Alexandr-Filatov/PDU_Container_MCU_PCB/Docs/Report Docs/Плата управления БРВН BOM_v1.0.xlsx

Позиционное обозначение | Номинал | Наименование | Замена | Корпус | Описание | Кол-во | DNP
C23, C25, C52, C54, C62, C64 | 0.1u |  |  | SMD 0805 | Capacitor SMD 50V | 6
C48 | 0.1u |  |  | SMD 1206 | Capacitor SMD 50V | 1
C10, C43, C58 | 0.27u |  |  | SMD 0805 | Capacitor SMD 50V | 3
C2, C3, C4, C5, C7, C11, C13, C14, C15, C17, C18, C41, C56, C59, C65, C73, C78 | 100n |  |  | SMD 0805 | Capacitor SMD 50V | 17
C20, C49, C67 | 10n |  |  | SMD 0805 | Capacitor SMD 50V | 3
C70, C71, C72, C80 | 10u |  |  | SMD 0805 | Capacitor SMD 50V | 4
C34, C35, C36, C37, C38, C44, C47, C66, C81, C82, C83, C85, C86, C87, C89, C90, C91, C92 | 10u |  |  | SMD 1206 | Capacitor SMD 50V | 18
C26, C30 | 12p |  |  | SMD 0805 | Capacitor SMD 50V | 2
C19, C74, C75, C76, C77 | 1u |  |  | SMD 0805 | Capacitor SMD 50V | 5
C39 | 1u |  |  | SMD 1206 | Capacitor SMD 50V | 1
C21, C22, C24, C27, C46, C53, C61, C63 | 2.2u |  |  | SMD 0805 | Capacitor SMD 50V | 8
C79, C84, C88 | 330u | EEUFR1H331L |  | CP Radial D10.0mm P5.00mm | Polarized capacitor | 3
C16 | 4.7u |  |  | SMD 0805 | Capacitor SMD 50V | 1
C68, C69 | 4.7u |  |  | SMD 1206 | Capacitor SMD 50V | 2
C1, C9, C12, C40, C42, C45, C55, C57, C60 | 56p |  |  | SMD 0805 | Capacitor SMD 50V | 9
D7, D16, D83 | ~ | S1M |  | SMA | Diode | 3
D24, D28, D32, D36 | ~ | RS1B |  | SMA | Fast recovery diode | 4
D20 | ~ | SMCJ33A |  | SMC | Supressor | 1
D8, D42 | ~ | FYLS-0603UBC |  | SMD 0805 | Blue LED | 2
D25, D29, D33, D37 | ~ | FYLS-0805UBC |  | SMD 0805 | Blue LED | 4
D11, D17, D22, D27, D31, D35, D39, D41 | ~ | FYLS-0805UYC |  | SMD 0805 | Yellow LED | 8
D6, D10, D81 | ~ | TO-3216BC-MYF |  | SMD 1206 | Yellow LED | 3
D40 | ~ | BZT52C10 |  | SOD-123 | Zener_Diode | 1
D5 | ~ | LBAT54HT1G |  | SOD-323 | Diode | 1
D2, D15, D82 | ~ | NSI1311 |  | SOIC-8 7.5x5.85mm P1.27mm | Isolated amplifier | 3
D14 | ~ | SM24CANB-02HTG |  | SOT-23 | Dual Line CAN Bus Protector, 24Vrwm | 1
D1, D3, D4, D9, D26, D30, D34, D38, D80 | ~ | BAT54S |  | SOT-23 | Schottky barrier diode | 9
D12 | ~ | TD301MCANFD |  | TD5(3)01MCANFD |  | 1
D21, D23 | ~ | UWE1215S-3WR3 |  | UWE S-3WR3 | DC/DC | 2
D18, D19 | ~ | WRB2405S-3WR2 |  | WRB S-3WR2 | DC/DC | 2
J3, J4, J5, J7, J8, J9, J10, J11, J12, J13, J14, J15, J32, J33 | ~ | DS1073-01-2x1-MVT6 |  | Mini-Fit 01x02 | Connector | 14
J6, J16, J17, J34, J35 | ~ | DS1073-01-2x2-MVT6 |  | Molex Mini-Fit Jr 5566-04A 2x02 P4.20mm | Connector | 5
J1 | ~ | KLS1-207-1-04-S | DS-1021-1x4 | PinHeader 1x04 P2.54mm | Connector | 1
L4, L6 | 4.7u | LQH44PN4R7MP0L |  | SMD 1210 | Inductor SMD | 2
L2 | 4.7u | NLC453232T-4R7K-PF |  | SMD 1812 | Inductor SMD | 1
L5, L7 | 470u | B82790C0474N215 |  | B82790S0513N201 | Inductor common mode SMD | 2
L3 | 6.8u | LQH32CN6R8M53L |  | SMD 1210 | Inductor SMD | 1
L1 | ~ | ACM2520-301-2P-T002 |  | CommonModeChoke TDK ACM2520-2P | Inductor SMD | 1
Q2, Q3, Q4, Q5 | ~ | BSP75N |  | SOT-223 | Self-Protected Low Side Driver with Temperature and Current Limit, SOT−223 | 4
Q7, Q8 | ~ | BC847 |  | SOT-23 | Bipolar N | 2
Q9, Q10 | ~ | BC857 |  | SOT-23 | Bipolar P | 2
Q1, Q6 | ~ | 20N06 |  | TO-252-2 | N_channel MOSFET | 2
R57 | 1.1k |  |  | SMD 0805 | Resistor SMD | 1
R55 | 100k |  |  | SMD 0805 | Resistor SMD | 1
R11, R14, R24, R62, R65, R68, R71, R74, R77, R80, R83, R88, R89, R90, R91 | 10k |  |  | SMD 0805 | Resistor SMD | 15
R7, R42, R135 | 120 |  |  | SMD 0805 | Resistor SMD | 3
R56, R87 | 14.3 |  |  | SMD 2512 | Resistor SMD | 2
R25, R26, R27, R28, R31, R34, R48, R51, R132 | 150k |  |  | SMD 2512 | Resistor SMD | 9
R4, R8, R12, R13, R18, R21, R33, R43, R46, R47, R59, R86, R92, R136, R139, R140 | 1k |  |  | SMD 0805 | Resistor SMD | 16
R54, R95 | 20 |  |  | SMD 0805 | Resistor SMD | 2
R23 | 23.2k |  |  | SMD 0805 | Resistor SMD | 1
R1, R2, R3, R6, R29, R30, R32, R41, R49, R50, R53, R134 | 2M |  |  | SMD 1206 | Resistor SMD | 12
R63, R69, R75, R81 | 3.3k |  |  | SMD 0805 | Resistor SMD | 4
R60, R66, R72, R78 | 330 |  |  | SMD 0805 | Resistor SMD | 4
R85 | 4.7k |  |  | SMD 0805 | Resistor SMD | 1
R84 | 470k |  |  | SMD 0805 | Resistor SMD | 1
R10, R45, R138 | 49.9 |  |  | SMD 0805 | Resistor SMD | 3
R37, R40 | 59 |  |  | SMD 0805 | Resistor SMD | 2
R39, R52 | 750 |  |  | SMD 0805 | Resistor SMD | 2
R61, R64, R67, R70, R73, R76, R79, R82 | 8.2k |  |  | SMD 0805 | Resistor SMD | 8
R5, R9, R38, R44, R133, R137 | 8k |  |  | SMD 1206 | Resistor SMD | 6
U7, U8, U9, U10, U11, U12, U13, U14 | ~ | PC817 |  | DIP-4 W7.62mm | Optocoupler | 8
U5 | ~ | APM32F405RGT6 |  | LQFP-64 10x10mm P0.5mm | MCU | 1
U4, U31 | ~ | TLV1117LV33DCYR |  | SOT-223-3 | Linear regulator | 2
U2, U3, U6, U17, U32, U33 | ~ | OPA333xxDBV |  | SOT-23-5 | Op-Amp | 6
U16 | ~ | USBLC6-2P6 |  | SOT-23-6 | ESD protection | 1
U15 | ~ | HT7550-1 |  | SOT-89-3 | Linear regulator | 1
Y1 | 16M | X322516MOB4SI |  | Crystal SMD SeikoEpson FA238-4Pin 3.2x2.5mm | Crystal | 1
