Alexandr-Filatov/PDU_Container_MCU_PCB/3D/WRA_S-3WR2.stp

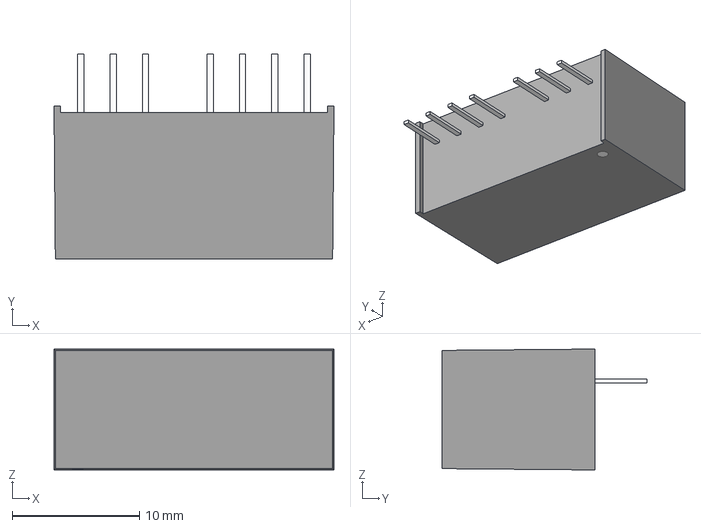
[picture p1: CAD file, 2026-06-05]
3D/WRA_S-3WR2.stp
22.0 x 16.1 x 9.50 mm
PIN_3_1_1_1 x 7
