Alexandr-Filatov/PDU_Container_MCU_PCB/3D/1-776087-1_v2.stp

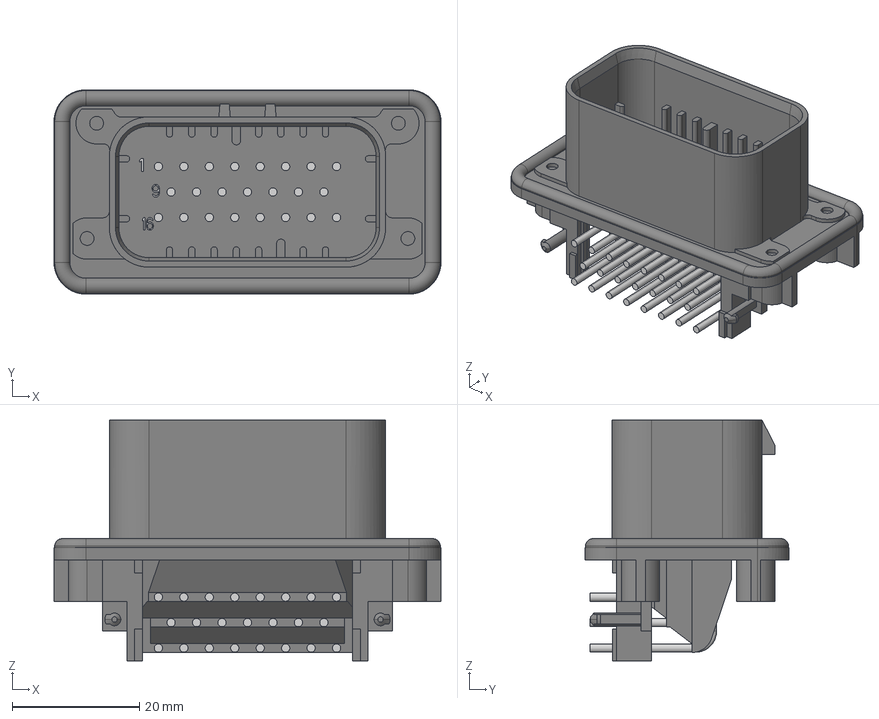
[picture p3: CAD file, 2026-06-05]
3D/1-776087-1_v2.stp
60.8 x 32.1 x 37.8 mm
