Alexandr-Filatov/PDU_Container_MCU_PCB/3D/FL2D-30-103.stp

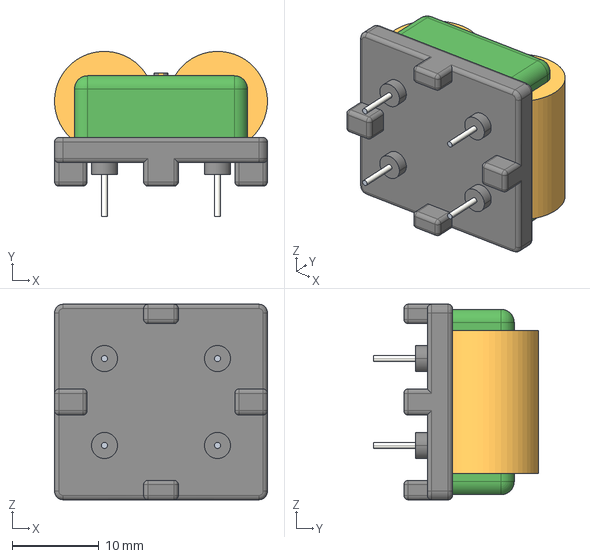
[picture p4: CAD file, 2026-06-05]
3D/FL2D-30-103.stp
24.5 x 19.0 x 22.5 mm
