Alexandr-Filatov/PDU_Container_MCU_PCB/3D/SMD Fuse SF-2410SP.stp

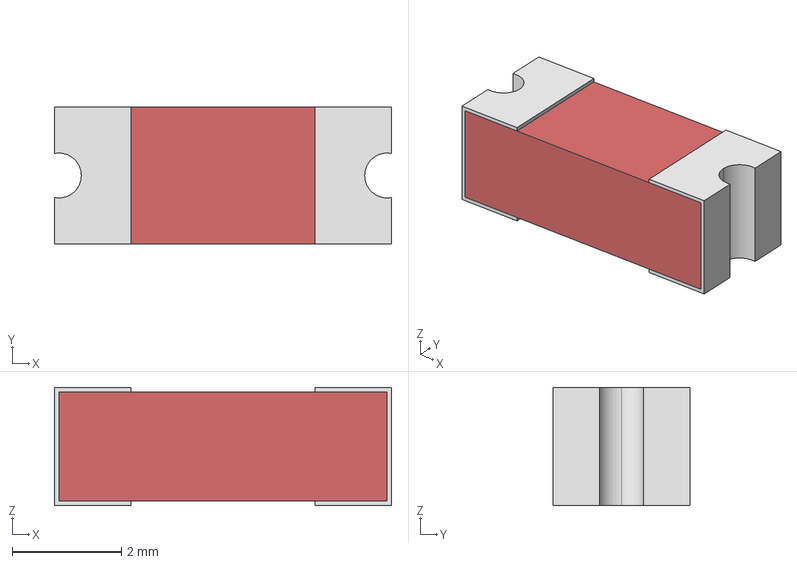
[picture p5: CAD file, 2026-06-05]
3D/SMD Fuse SF-2410SP.stp
6.16 x 2.50 x 2.16 mm
