Alexandr-Filatov/PDU_Container_MCU_PCB/3D/UWE_S-3WR3.stp

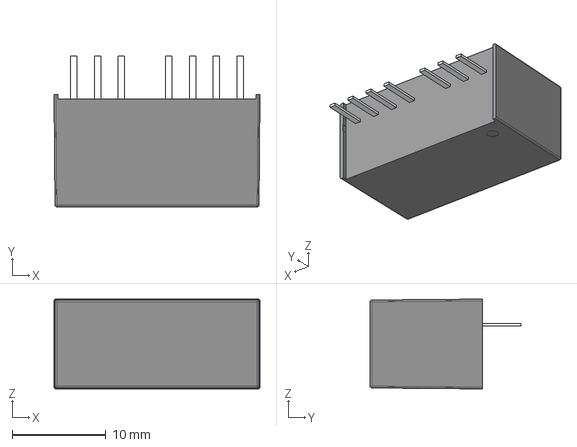
[picture p7: CAD file, 2026-06-05]
3D/UWE_S-3WR3.stp
22.0 x 16.1 x 9.60 mm
