Alexandr-Filatov/PDU_Container_MCU_PCB/3D/NSI1311.stp

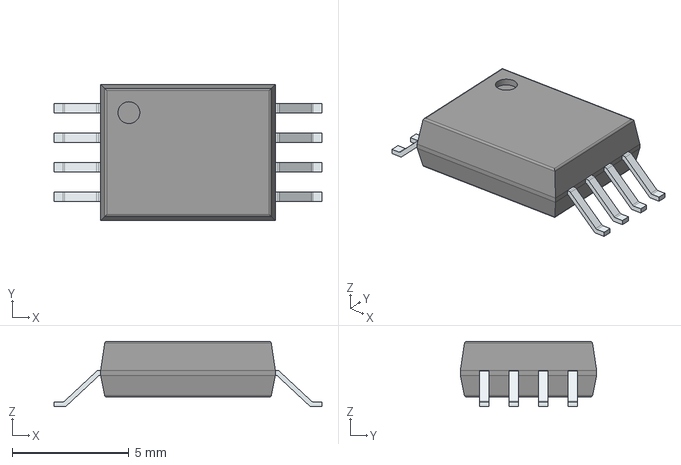
[picture p8: CAD file, 2026-06-05]
3D/NSI1311.stp
11.5 x 5.85 x 2.80 mm
PinsArrayLR
