Alexandr-Filatov/PDU_Container_MCU_PCB/3D/TD5(3)01MCAN.stp

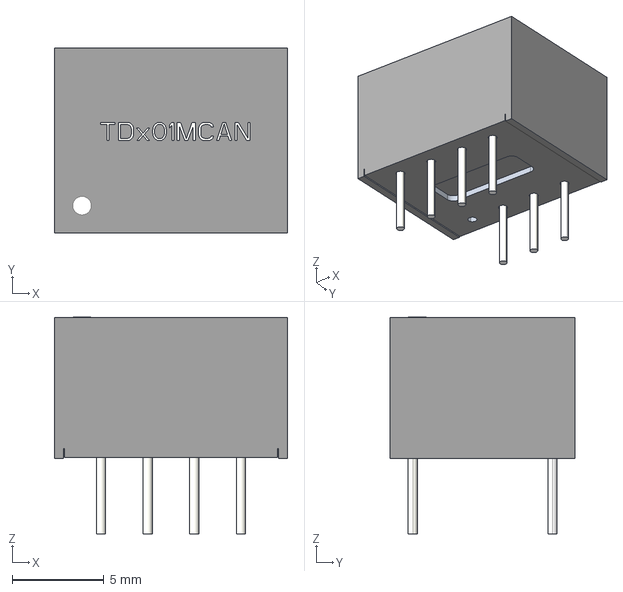
[picture p10: CAD file, 2026-06-05]
3D/TD5(3)01MCAN.stp
12.7 x 10.1 x 11.8 mm
