Alexandr-Filatov/PDU_Container_MCU_PCB/3D/IND_DLW5BS_2020_MUR.step

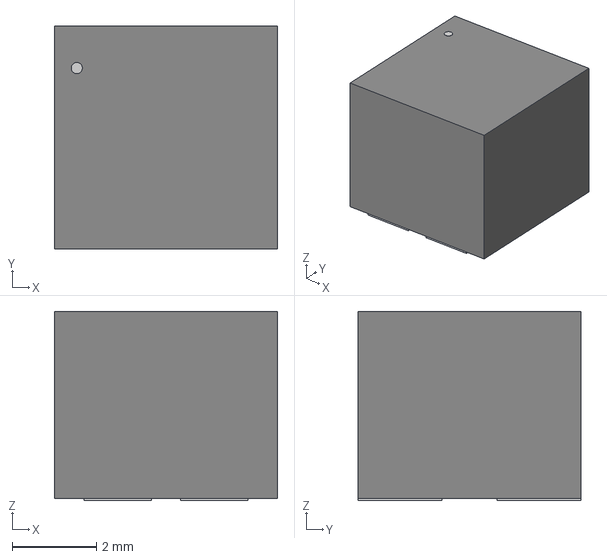
[picture p11: CAD file, 2026-06-05]
3D/IND_DLW5BS_2020_MUR.step
5.30 x 5.30 x 4.50 mm
