Alexandr-Filatov/PDU_Container_MCU_PCB/3D/Tyco KiloVac EV200 Contactor.STEP

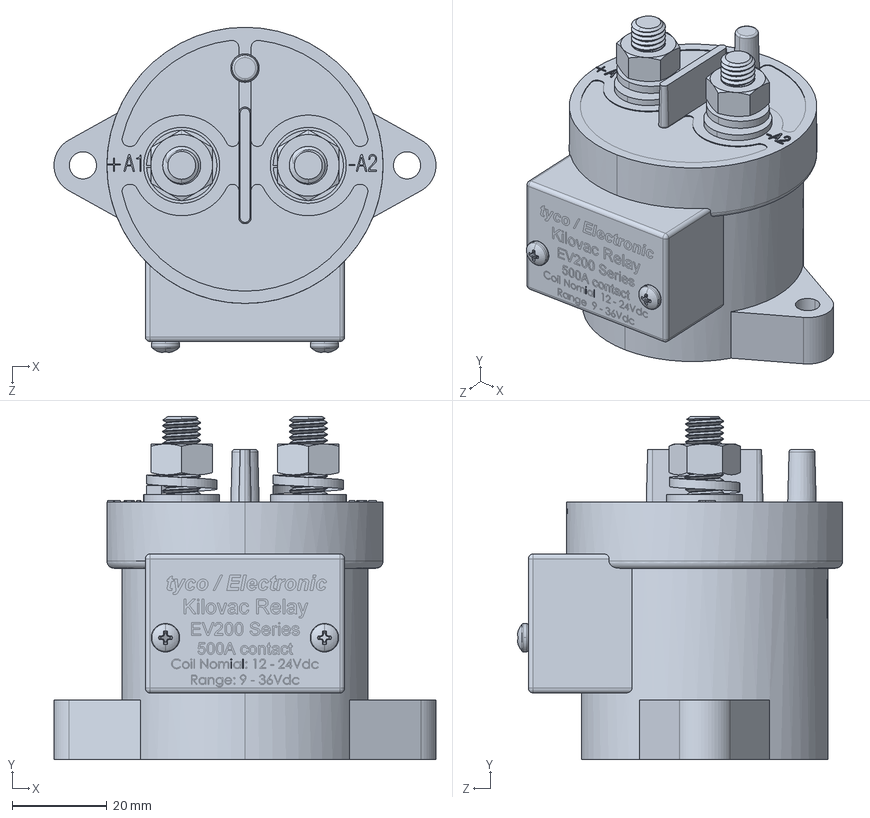
[picture p12: CAD file, 2026-06-05]
3D/Tyco KiloVac EV200 Contactor.STEP
80.5 x 72.3 x 68.6 mm
