Alexandr-Filatov/PDU_Container_MCU_PCB/3D/0039288040.stp

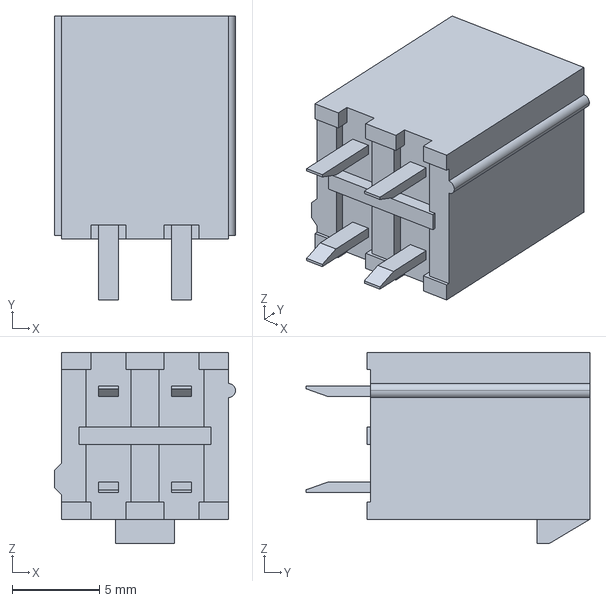
[picture p13: CAD file, 2026-06-05]
3D/0039288040.stp
10.4 x 16.3 x 11.0 mm
