Alexandr-Filatov/PDU_Container_MCU_PCB/3D/2071583-4.stp

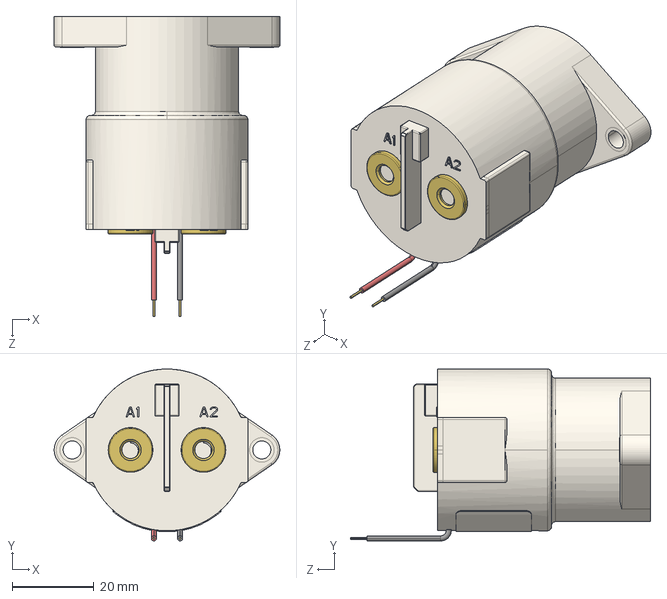
[picture p14: CAD file, 2026-06-05]
3D/2071583-4.stp
55.1 x 42.0 x 73.2 mm
