Alexandr-Filatov/PDU_Container_MCU_PCB/3D/0353180420.stp

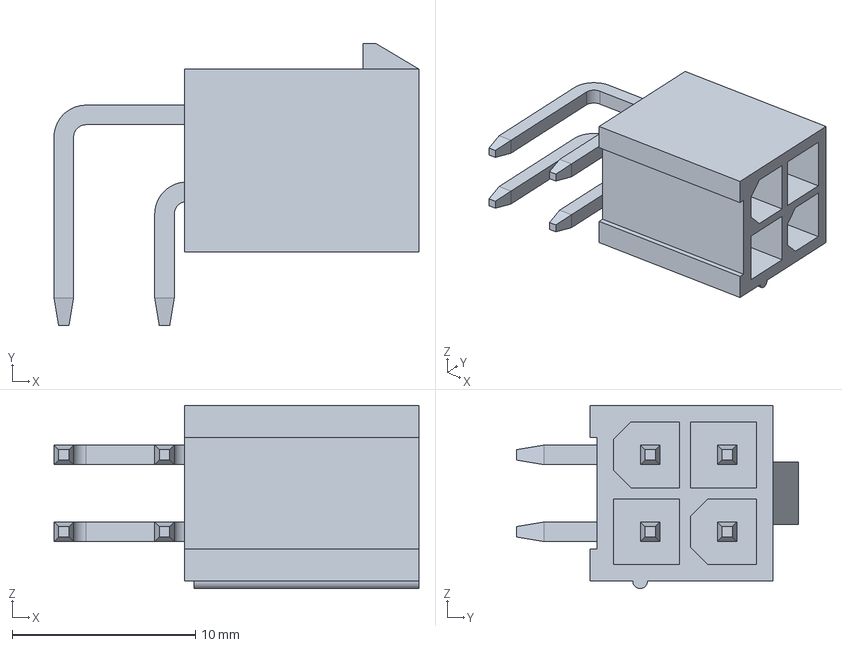
[picture p15: CAD file, 2026-06-05]
3D/0353180420.stp
19.9 x 15.4 x 10.0 mm
