Alexandr-Filatov/PDU_Container_MCU_PCB/3D/0300700235.stp

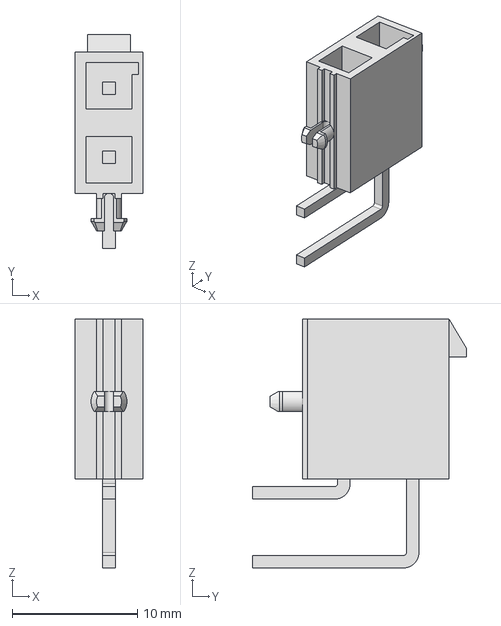
[picture p16: CAD file, 2026-06-05]
3D/0300700235.stp
5.40 x 17.1 x 19.9 mm
