Alexandr-Filatov/PDU_Container_MCU_PCB/(list of files, cad)

Other CAD files:
Drawings/НВЦТ.EVP150-2-1.2000.120_v1.dwg
3D/1-776087-1.step
3D/0039281063.stp
3D/039288020.stp
3D/B82790C0474N215.stp
