Alexandr-Filatov/PDU_Container_MCU_PCB/Docs/Report Docs/Плата управления БРВН монтажная схема вид снизу_v1.0.pdf

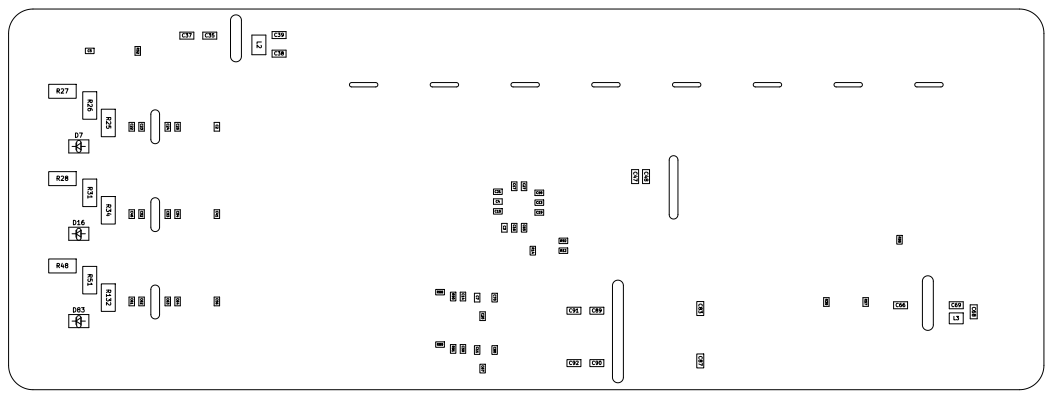
[picture p18: page 1]

Size: A2 | Rev:
KiCad E.D.A. 10.0.1 | Id: 1/1
