Alexandr-Filatov/PDU_Container_MCU_PCB/Docs/Report Docs/Плата управления БРВН схема Э2_v1.0.pdf

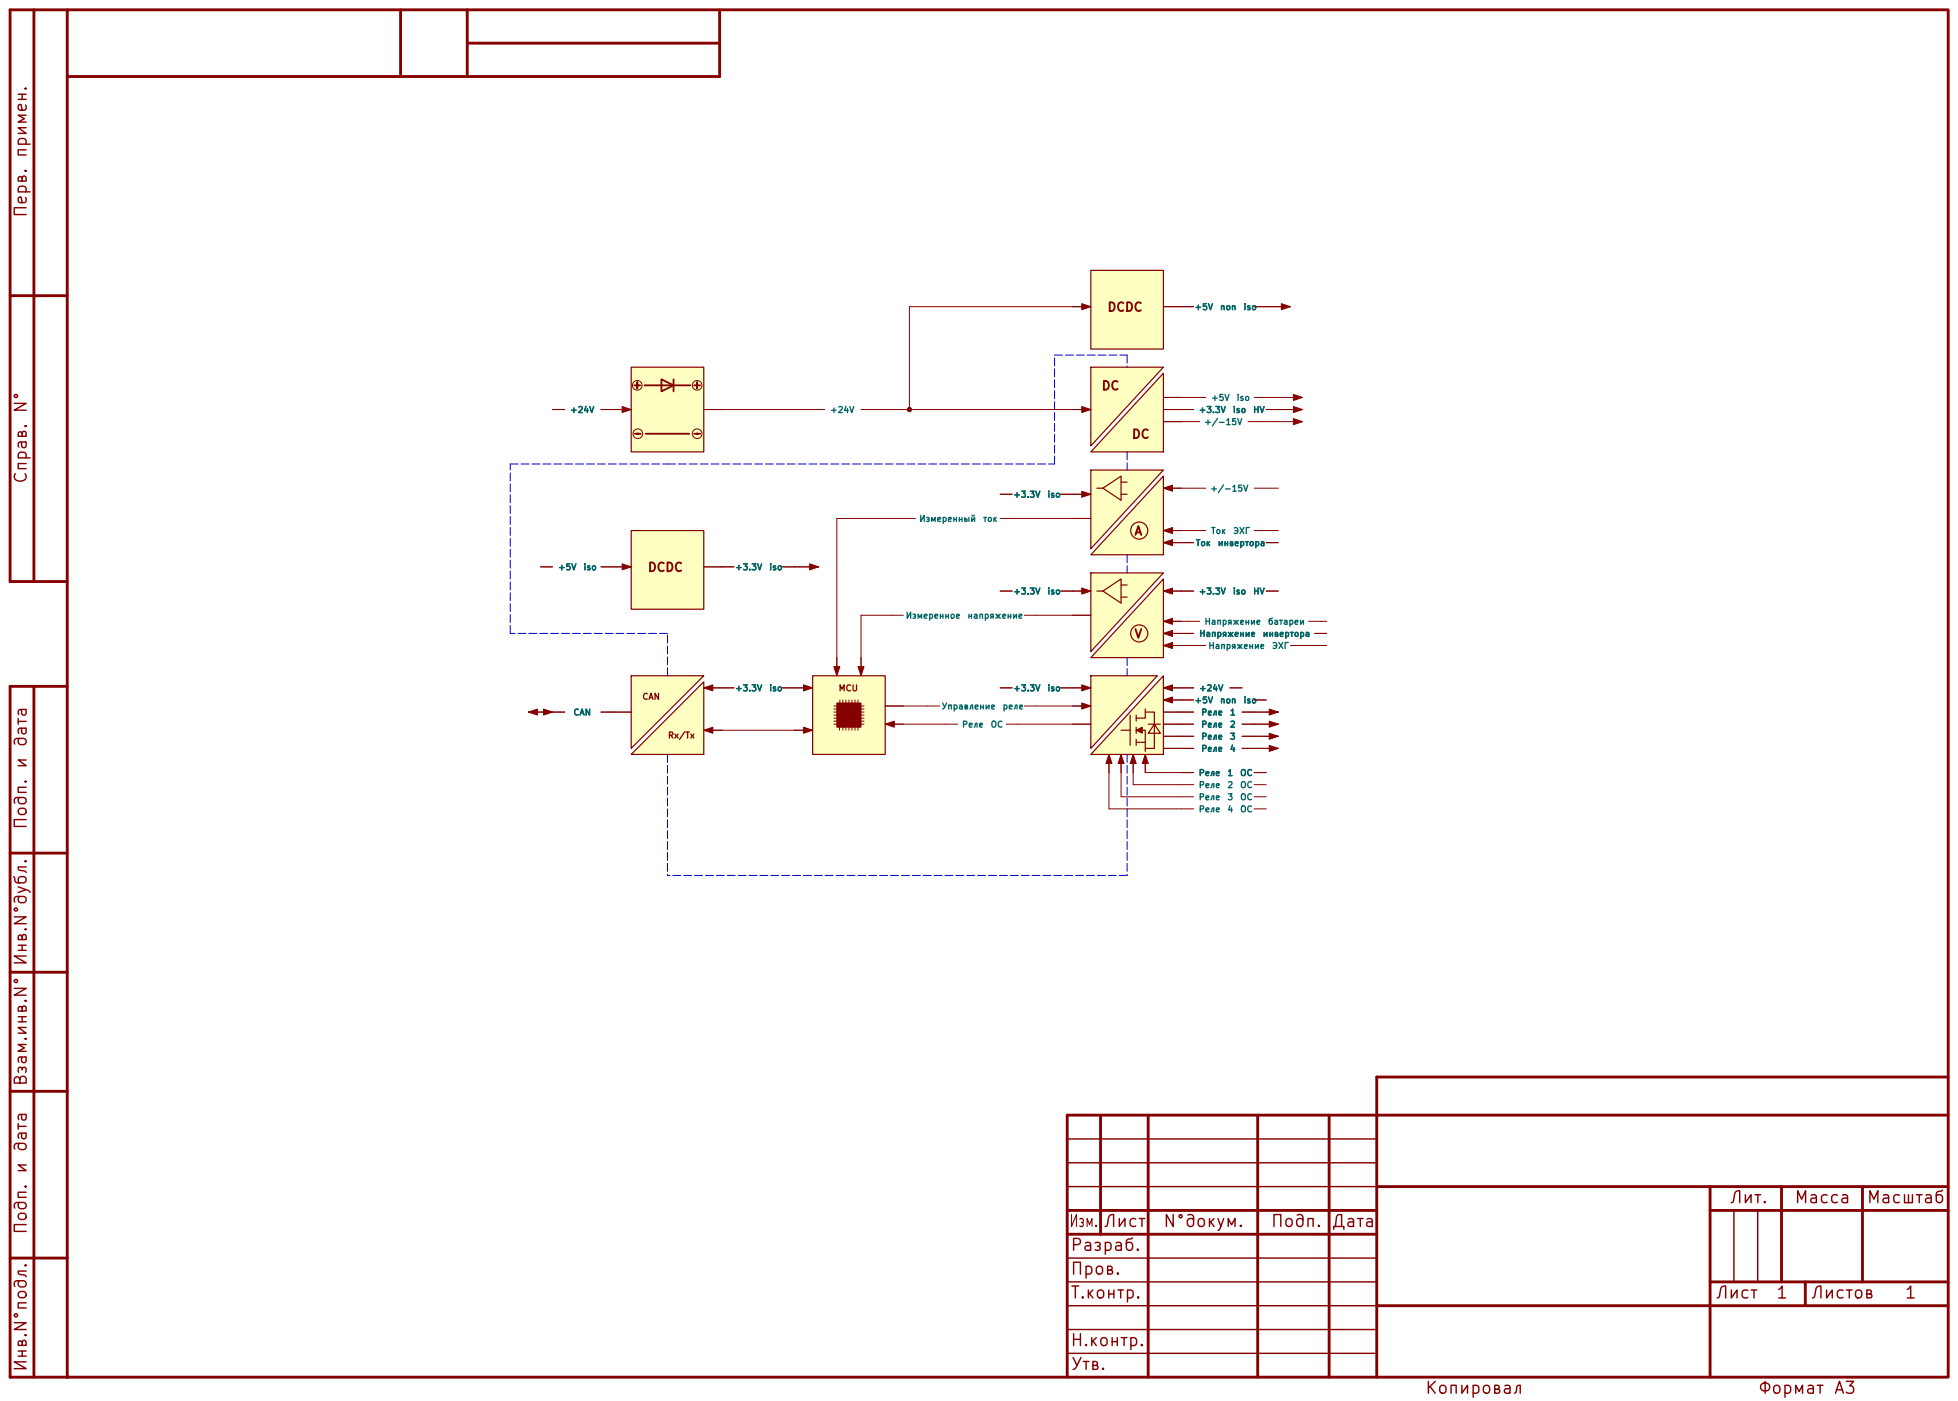
[picture p19: page 1]

Н.контр. Перв. примен. Подп. и дата Подп. и дата

Ток инвертора +3.3V iso HV Реле 4 Реле 1 ОС

Напряжение инвертора Реле 4 Реле 2 ОС
Реле 1 ОС Напряжение ЭХГ +5V non iso Реле 3 Реле 1 +24V

Пров.
Т.контр.
