Alexandr-Filatov/PDU_Container_MCU_PCB/Docs/Report Docs/Плата управления БРВН схема Э3_v1.0.pdf

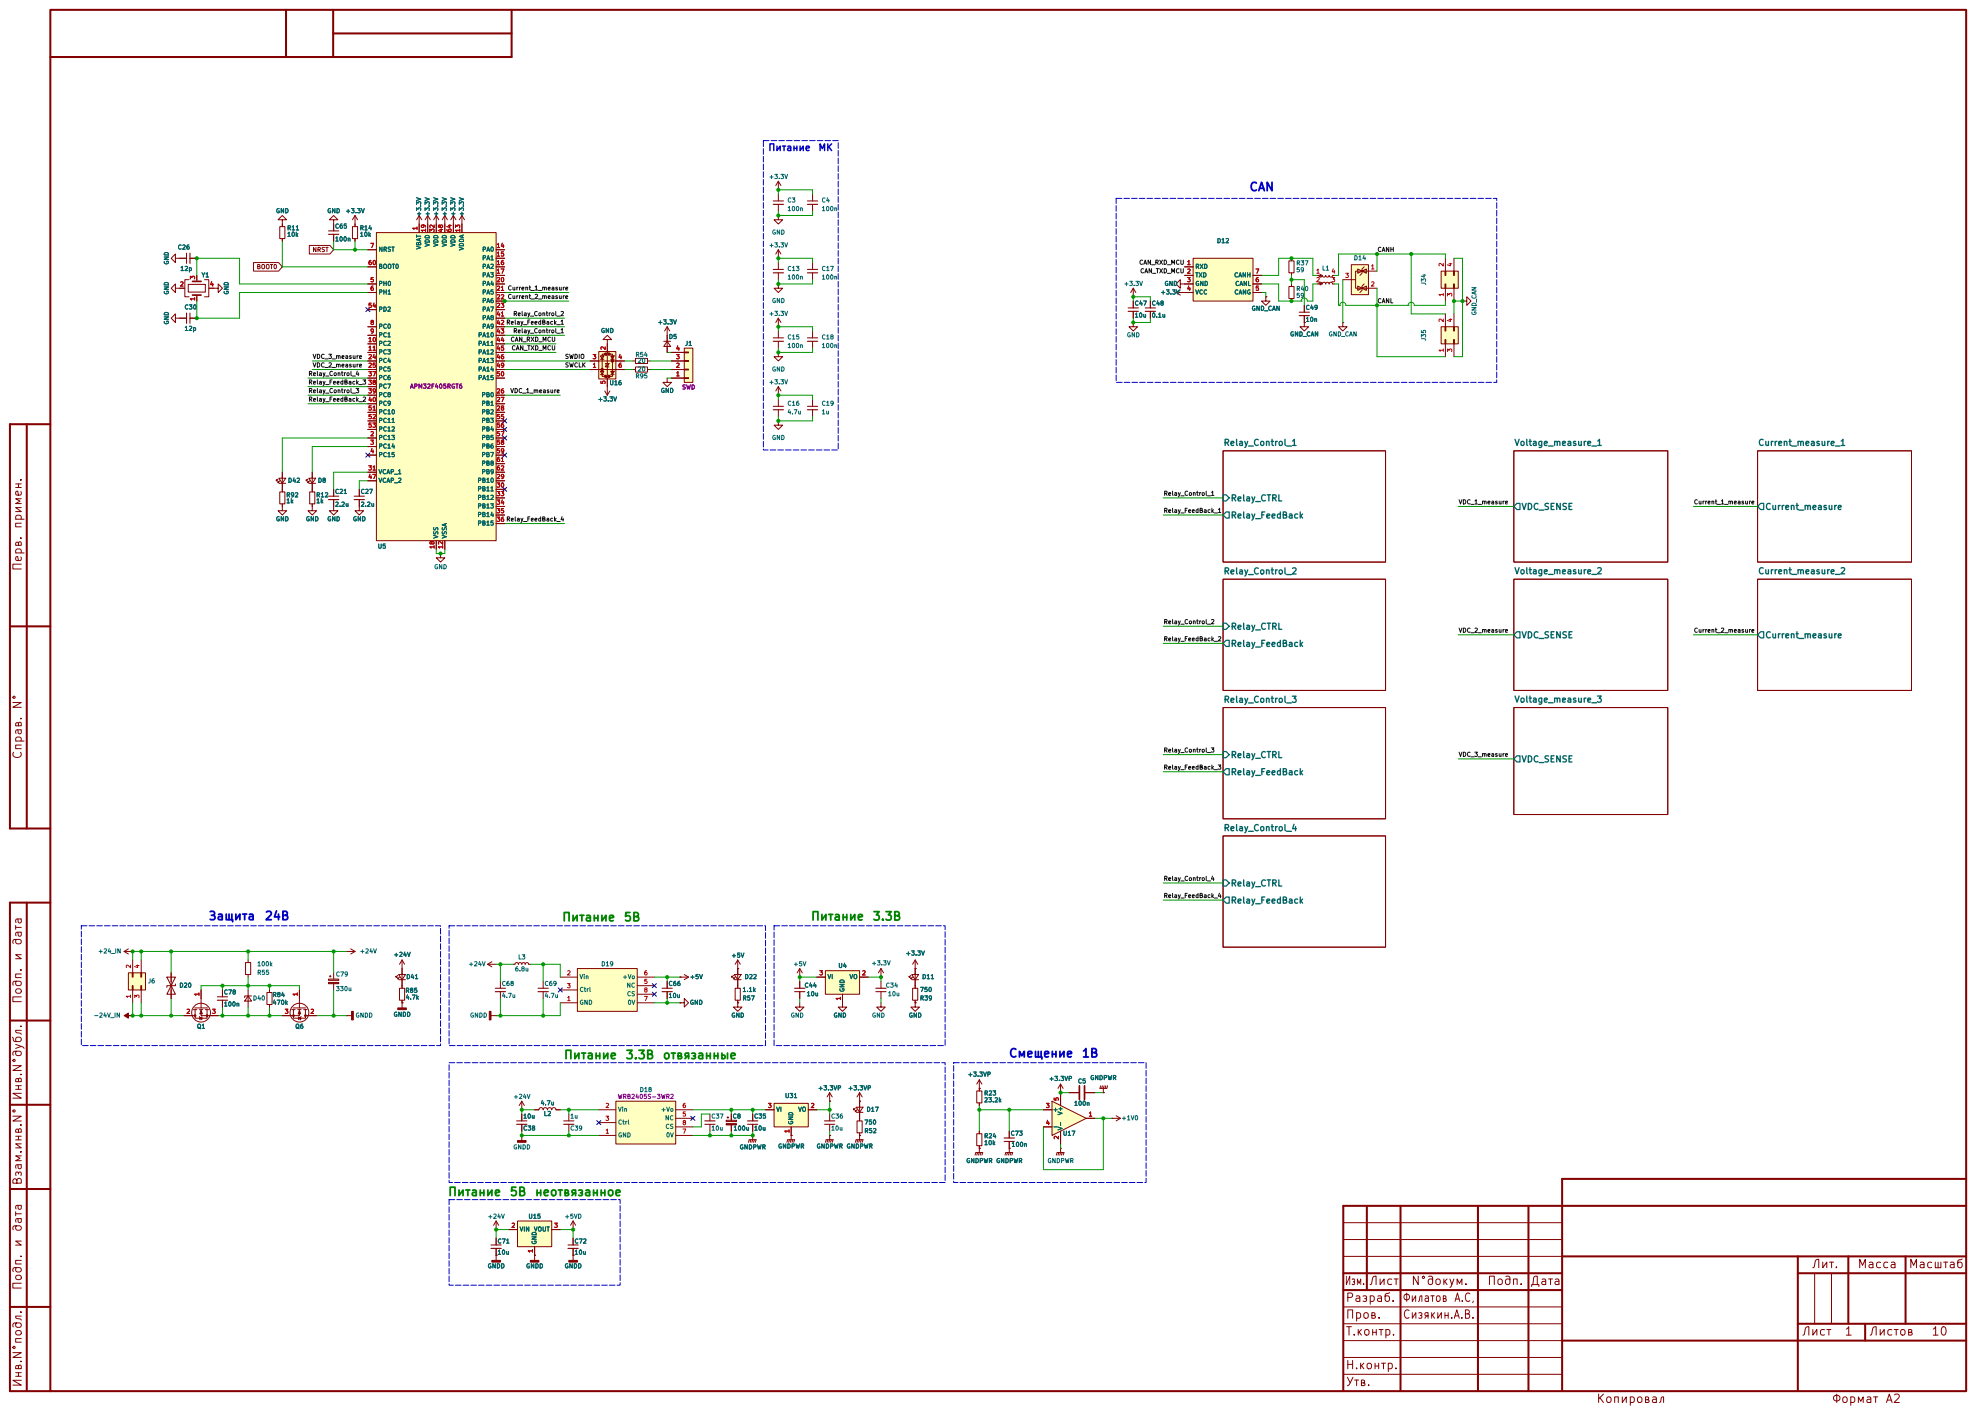
[picture p20: page 1]

Н.контр. Перв. примен. Подп. и дата Подп. и дата

Лист | | Подп.
Филатов А.С,

Пров. | | Сизякин.А.В.
Т.контр.

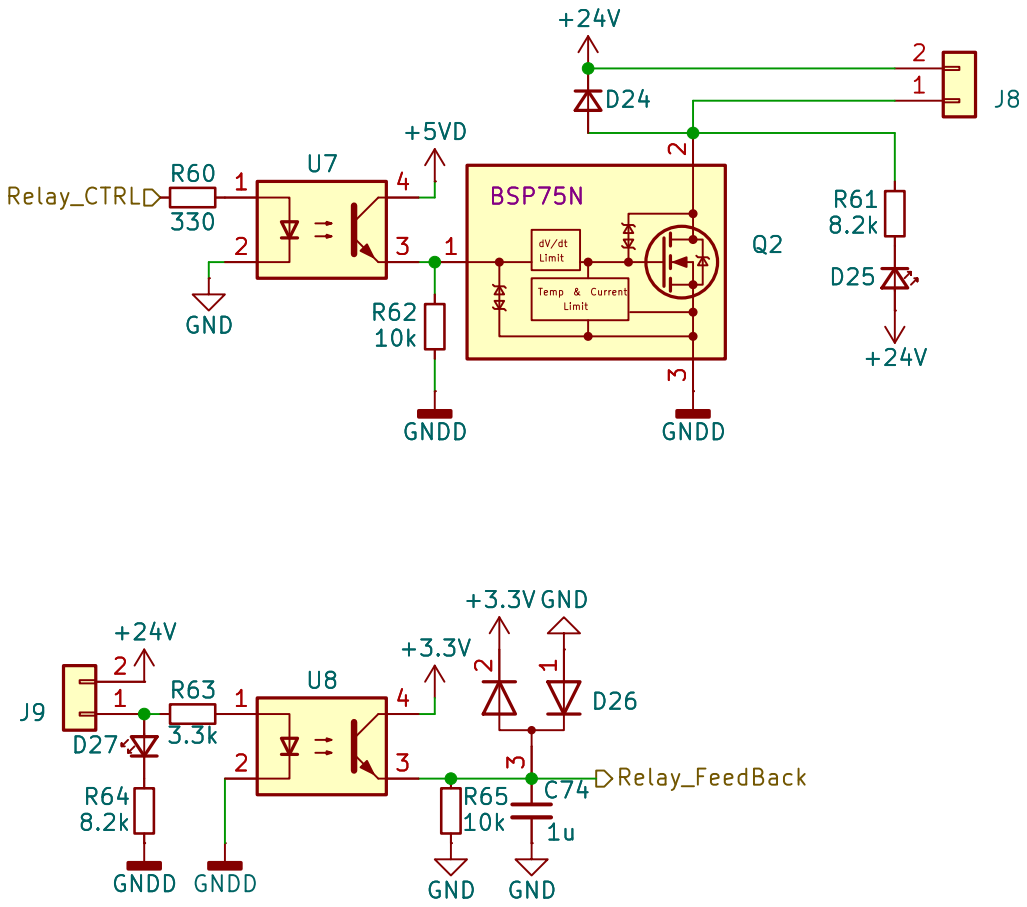
[picture p21: page 2]

Лист Подп. и дата Подп. и дата

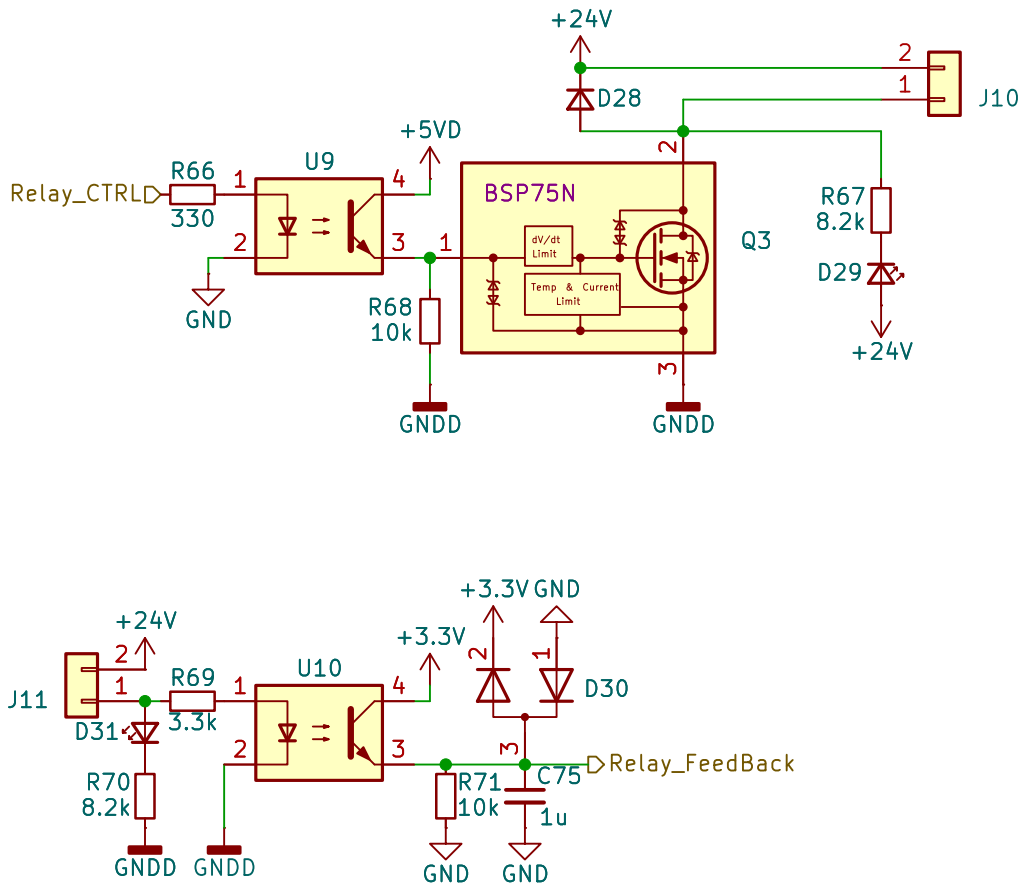
[picture p22: page 3]

Лист Подп. и дата Подп. и дата

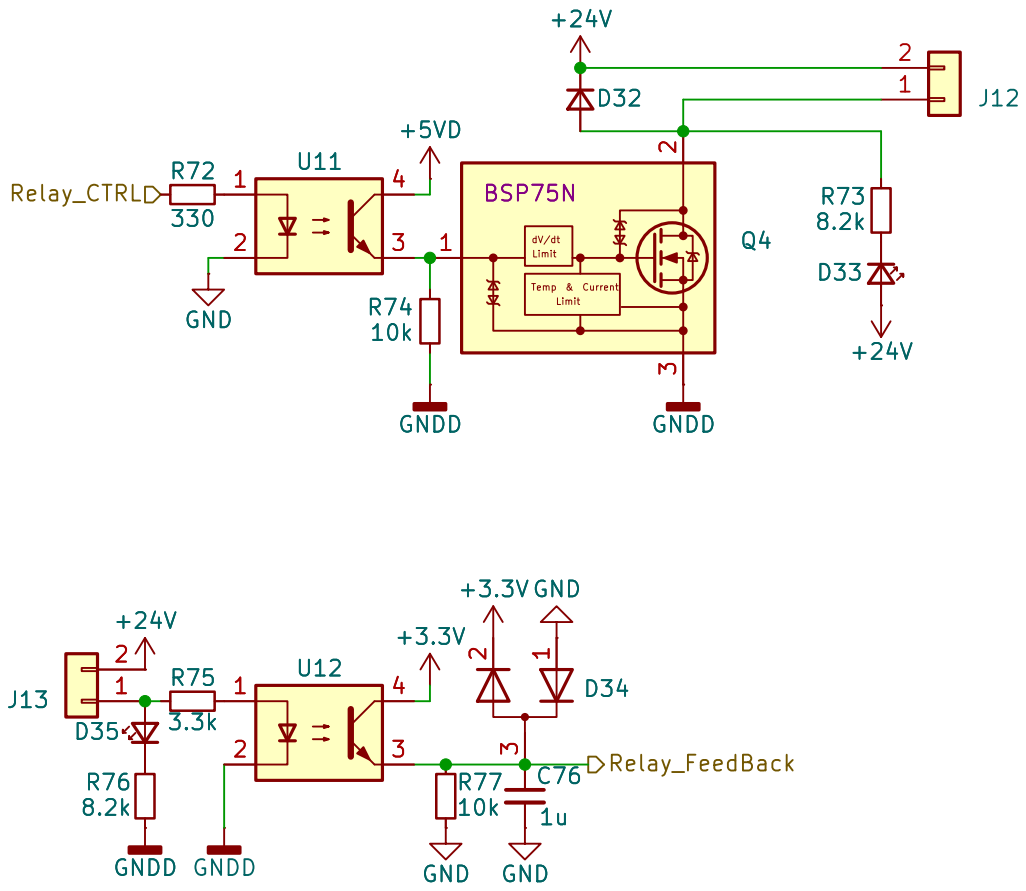
[picture p23: page 4]

Лист Подп. и дата Подп. и дата

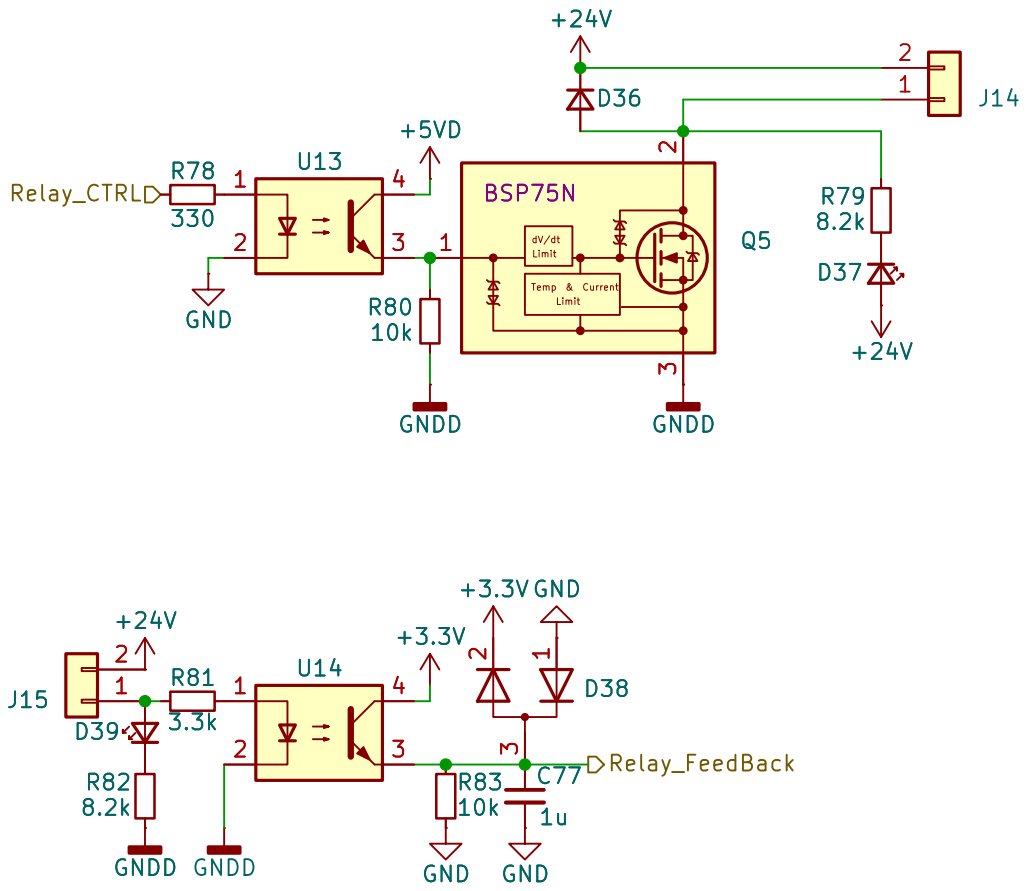
[picture p24: page 5]

Лист Подп. и дата Подп. и дата

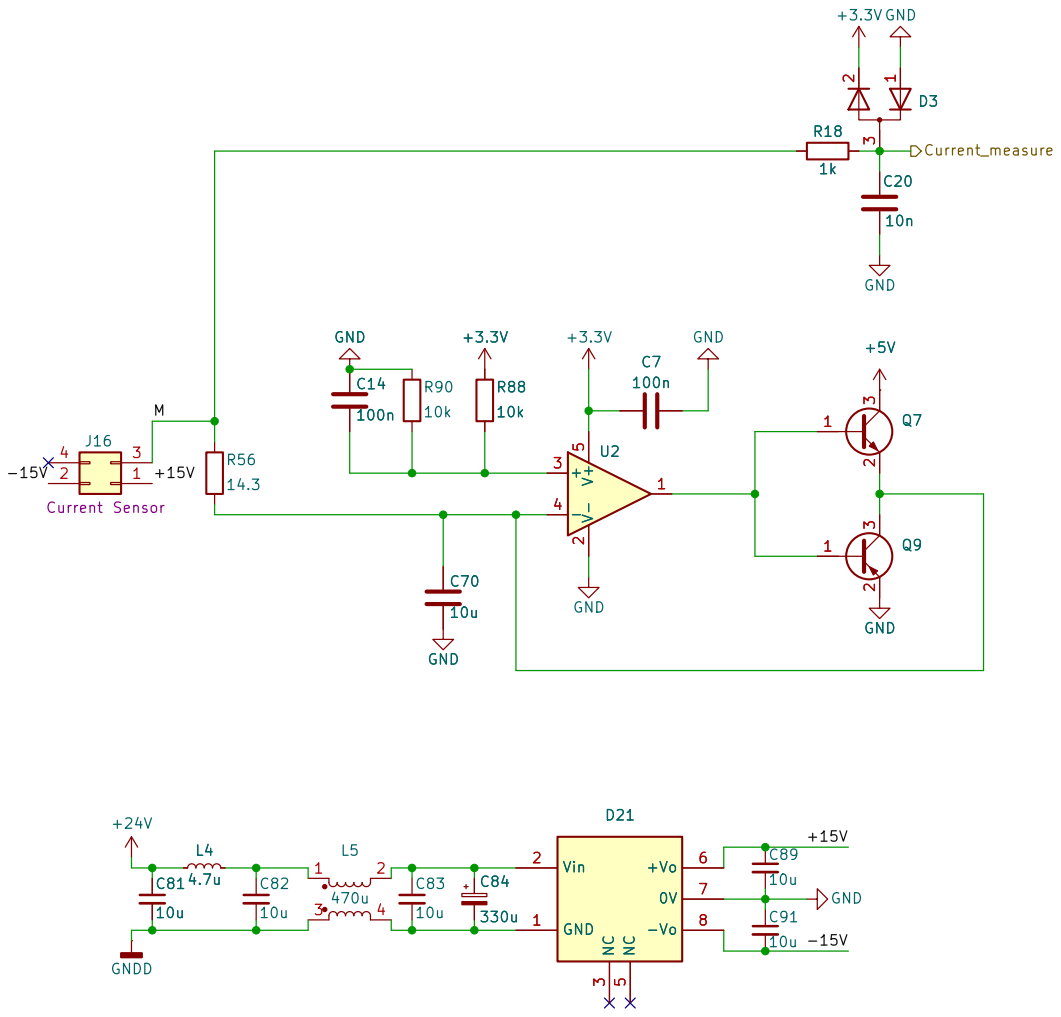
[picture p25: page 6]

Лист Подп. и дата Подп. и дата

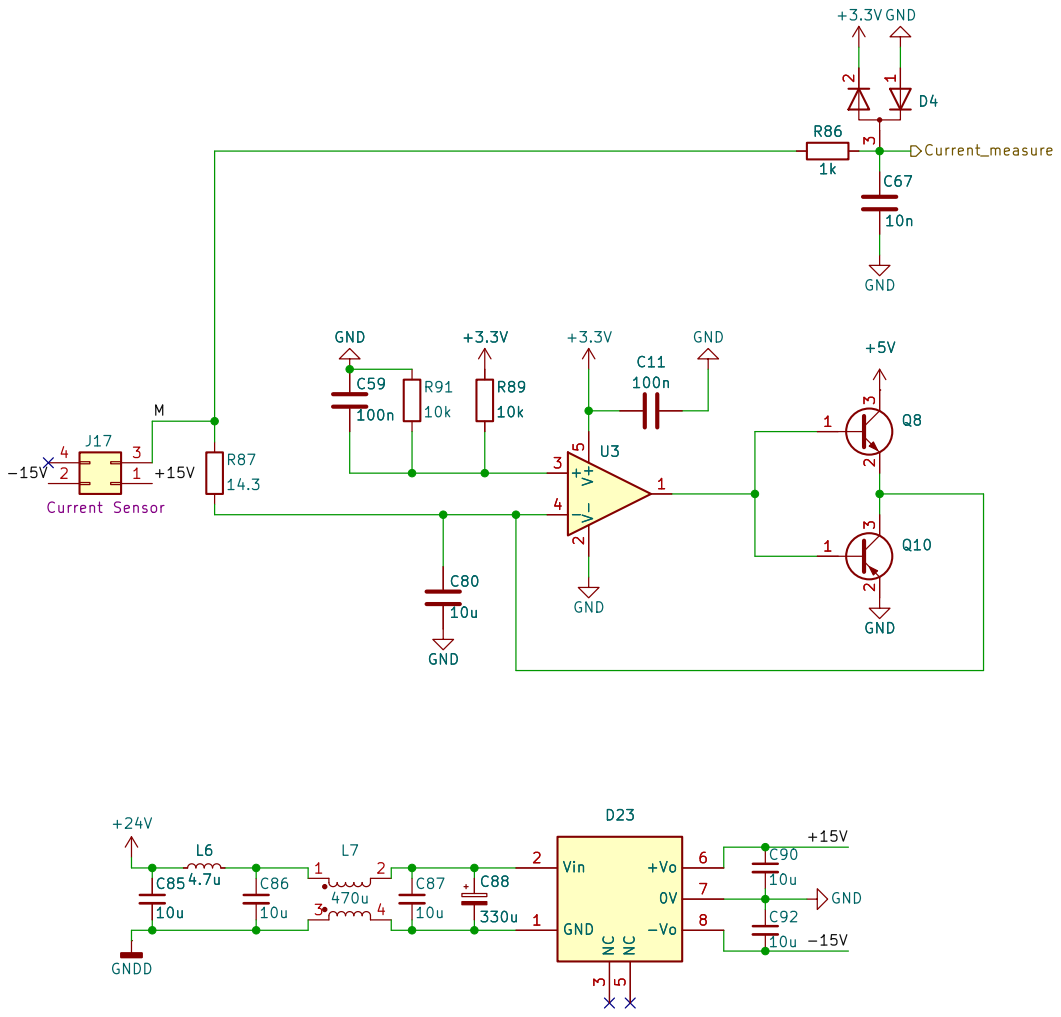
[picture p26: page 7]

Лист Подп. и дата Подп. и дата

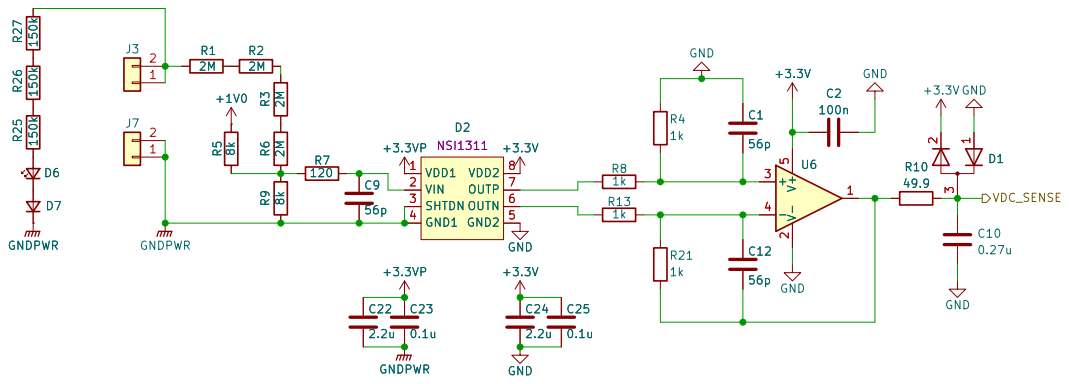
[picture p27: page 8]

Лист Подп. и дата Подп. и дата

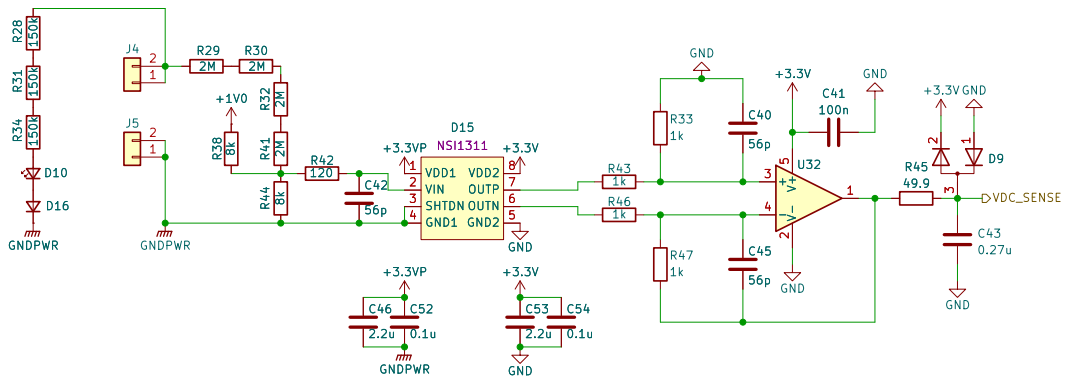
[picture p28: page 9]

Лист Подп. и дата Подп. и дата

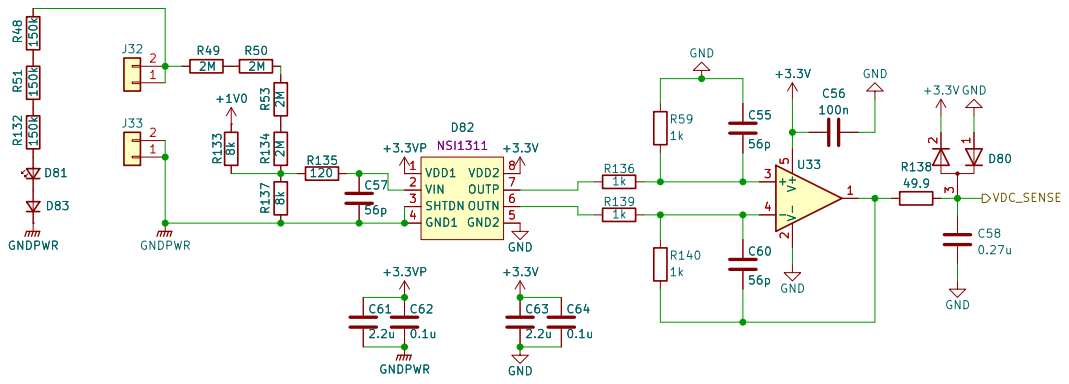
[picture p29: page 10]

Лист Подп. и дата Подп. и дата
