Alexandr-Filatov/PDU_Container_MCU_PCB/PDU_Container_MCU_PCB.kicad_pcb

## KiCad design PDU_Container_MCU_PCB.kicad_pcb (2026-07-08)

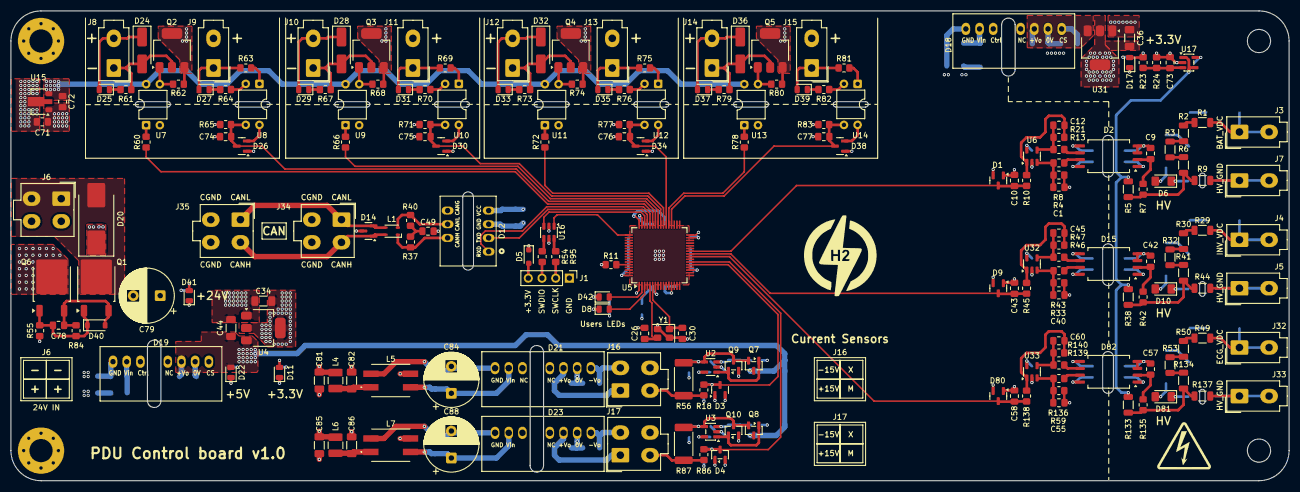
[picture p30: board PDU_Container_MCU_PCB.kicad_pcb from above]

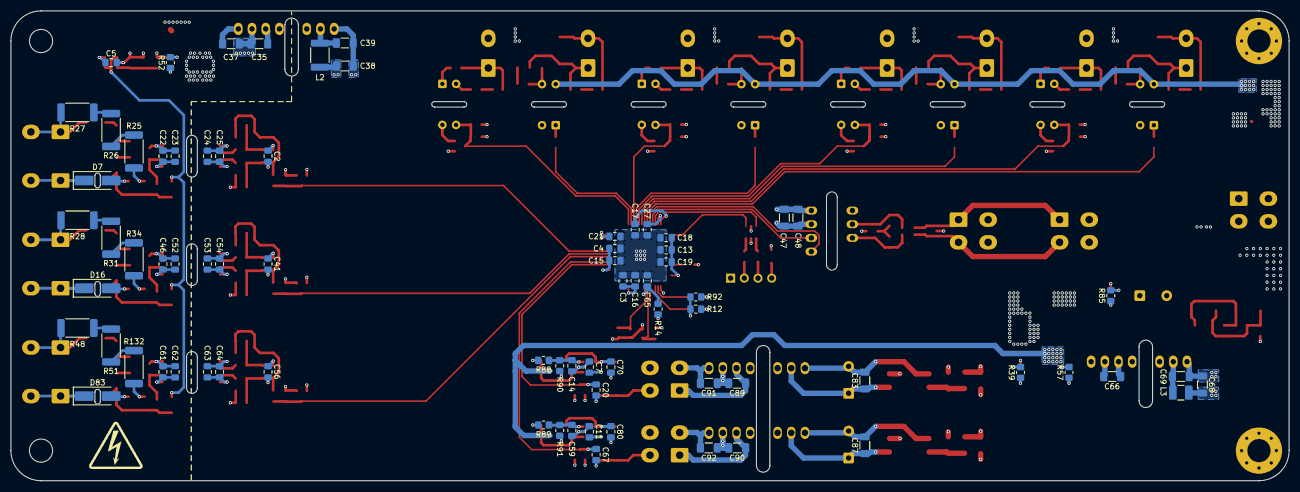
[picture p31: board PDU_Container_MCU_PCB.kicad_pcb from below]

Board: 4 copper layers, 237.2 x 87.2 mm, 283 parts (75 on the bottom side), 150 nets.

Parts:
C1, C9, C12, C40, C42, C45, C55, C57, C60: 56p; C_0805_2012Metric_Pad1.18x1.45mm_HandSolder
C2, C3, C4, C5, C7, C11, C13, C14, C15, C17, C18, C23, C25, C41, C52, C54, C56, C59, C62, C64, C65, C73, C78: 100n; C_0805_2012Metric_Pad1.18x1.45mm_HandSolder
C10, C43, C58: 220n; C_0805_2012Metric_Pad1.18x1.45mm_HandSolder
C16: 4.7u; C_0805_2012Metric_Pad1.18x1.45mm_HandSolder
C19, C74, C75, C76, C77: 1u; C_0805_2012Metric_Pad1.18x1.45mm_HandSolder
C20, C49, C67: 10n; C_0805_2012Metric_Pad1.18x1.45mm_HandSolder
C21, C22, C24, C27, C46, C53, C61, C63: 2.2u; C_0805_2012Metric_Pad1.18x1.45mm_HandSolder
C26, C30: 12p; C_0805_2012Metric_Pad1.18x1.45mm_HandSolder
C34, C35, C36, C37, C38, C44, C47, C66, C81, C82, C83, C85, C86, C87, C89, C90, C91, C92: 10u; C_1206_3216Metric_Pad1.33x1.80mm_HandSolder
C39: 1u; C_1206_3216Metric_Pad1.33x1.80mm_HandSolder
C48: 100n; C_1206_3216Metric_Pad1.33x1.80mm_HandSolder
C68, C69: 4.7u; C_1206_3216Metric_Pad1.33x1.80mm_HandSolder
C70, C71, C72, C80: 10u; C_0805_2012Metric_Pad1.18x1.45mm_HandSolder
C79, C84, C88: 330u; CP_Radial_D10.0mm_P5.00mm
D1, D3, D4, D9, D14, D26, D30, D34, D38, D80: SOT-23
D2, D15, D82: SOIC-8_7.5x5.85mm_P1.27mm
D5: D_SOD-323_HandSoldering
D6, D10, D81: LED_1206_3216Metric_Pad1.42x1.75mm_HandSolder
D7, D16, D24, D28, D32, D36, D83: D_SMA_Handsoldering
D8, D11, D17, D22, D25, D27, D29, D31, D33, D35, D37, D39, D41, D42: LED_0805_2012Metric
D12: TD5(3)01MCANFD
D13: Logo; Logo_Company_1
D18, D19: WRB_S-3WR2
D20: D_SMC_Handsoldering
D21, D23: UWE_S-3WR3
D40: D_SOD-123
H1, H2: MountingHole_Pad; MountingHole_4.3mm_M4_Pad_Via
H3, H4: MountingHole; MountingHole_4.3mm_M4
J1: PinHeader_1x04_P2.54mm_Vertical
J3, J4, J5, J7, J8, J9, J10, J11, J12, J13, J14, J15, J32, J33: Mini-Fit_01x02_Vertical
J6, J16, J17, J34, J35: Molex_Mini-Fit_Jr_5566-04A_2x02_P4.20mm_Vertical
L1: L_CommonModeChoke_TDK_ACM2520-2P
L2: 4.7u; L_1812_4532Metric_Pad1.30x3.40mm_HandSolder
L3: 6.8u; L_1210_3225Metric_Pad1.42x2.65mm_HandSolder
L4, L6: 4.7u; L_1210_3225Metric_Pad1.42x2.65mm_HandSolder
L5, L7: 470u; B82790S0513N201
Q1, Q6: TO-252-2
Q2, Q3, Q4, Q5: SOT-223
Q7, Q8, Q9, Q10: SOT-23
R1, R2, R3, R6, R29, R30, R32, R41, R49, R50, R53, R134: 2M; R_1206_3216Metric
R4, R8, R12, R13, R18, R21, R33, R39, R43, R46, R47, R52, R57, R59, R86, R92, R136, R139, R140: 1k; R_0805_2012Metric_Pad1.20x1.40mm_HandSolder
R5, R9, R38, R44, R133, R137: 8k; R_1206_3216Metric
R7, R10, R42, R45, R135, R138: 120; R_0805_2012Metric_Pad1.20x1.40mm_HandSolder
R11, R14, R24, R62, R65, R68, R71, R74, R77, R80, R83, R88, R89, R90, R91: 10k; R_0805_2012Metric_Pad1.20x1.40mm_HandSolder
R23: 23.2k; R_0805_2012Metric_Pad1.20x1.40mm_HandSolder
R25, R26, R27, R28, R31, R34, R48, R51, R132: 150k; R_2512_6332Metric_Pad1.40x3.35mm_HandSolder
R37, R40: 59; R_0805_2012Metric_Pad1.20x1.40mm_HandSolder
R54, R95: 20; R_0805_2012Metric_Pad1.20x1.40mm_HandSolder
R55: 100k; R_0805_2012Metric_Pad1.20x1.40mm_HandSolder
R56, R87: 14.3; R_2512_6332Metric_Pad1.40x3.35mm_HandSolder
R60, R66, R72, R78: 330; R_0805_2012Metric_Pad1.20x1.40mm_HandSolder
R61, R64, R67, R70, R73, R76, R79, R82: 8.2k; R_0805_2012Metric_Pad1.20x1.40mm_HandSolder
R63, R69, R75, R81: 3.3k; R_0805_2012Metric_Pad1.20x1.40mm_HandSolder
R84: 470k; R_0805_2012Metric_Pad1.20x1.40mm_HandSolder
R85: 4.7k; R_0805_2012Metric_Pad1.20x1.40mm_HandSolder
U2, U3, U6, U17, U32, U33: SOT-23-5
U4, U31: SOT-223-3_TabPin2
U5: LQFP-64_10x10mm_P0.5mm
U7, U8, U9, U10, U11, U12, U13, U14: DIP-4_W7.62mm
U15: SOT-89-3
U16: SOT-23-6
Y1: 16M; Crystal_SMD_SeikoEpson_FA238-4Pin_3.2x2.5mm

Connections:
+1V0: R5.2, R38.2, R133.2, U17.1, U17.4 (-)
+3.3V: C2.1, C3.1, C4.1, C7.1, C11.1, C13.1, C15.1, C16.1, C17.1, C18.1, C19.1, C24.2, C25.1, C34.2, C41.1, C47.1, C48.1, C53.2, C54.1, C56.1, C63.2, C64.1, D1.2 (K), D2.8 (VDD2), D3.2 (K), D4.2 (K), D5.1 (K), D9.2 (K), D11.2 (A), D12.4 (VCC), D15.8 (VDD2), D26.2 (K), D30.2 (K), D34.2 (K), D38.2 (K), D80.2 (K), D82.8 (VDD2), R14.1, R88.1, R89.1, U2.5 (V+), U3.5 (V+), U4.2 (VO), U5.1 (VBAT), U5.13 (VDDA), U5.19 (VDD), U5.32 (VDD), U5.48 (VDD), U5.64 (VDD), U6.5 (V+), U8.4, U10.4, U12.4, U14.4, U16.5 (VBUS), U32.5 (V+), U33.5 (V+)
+3.3VP: C5.1, C22.2, C23.1, C36.2, C46.2, C52.1, C61.2, C62.1, D2.1 (VDD1), D15.1 (VDD1), D17.2 (A), D82.1 (VDD1), R23.1, U17.5 (V+), U31.2 (VO)
+5V: C44.2, C66.1, D19.6 (+Vo), D22.2 (A), Q7.3 (C), Q8.3 (C), U4.3 (VI)
+5VD: C72.1, U7.4, U9.4, U11.4, U13.4, U15.3 (VOUT)
+24V: C38.1, C68.1, C71.1, C79.1, C81.1, C85.1, D20.1 (A1), D24.1 (K), D25.2 (A), D28.1 (K), D29.2 (A), D32.1 (K), D33.2 (A), D36.1 (K), D37.2 (A), D41.2 (A), J6.2, J6.4, J8.2, J9.2, J10.2, J11.2, J12.2, J13.2, J14.2, J15.2, L2.1, L3.1, L4.1, L6.1, R55.2, U15.2 (VIN)
-24V_IN: D20.2 (A2), J6.1, J6.3, Q1.2 (D)
/CANH: D14.1 (K), J34.2, J35.2, L1.4
/CANL: D14.2 (K), J34.1, J35.1, L1.3
/CAN_RXD_MCU: D12.1 (RXD), U5.44 (PA11)
/CAN_TXD_MCU: D12.2 (TXD), U5.45 (PA12)
/Current_1_measure: C20.1, D3.3 (common), R18.2, U5.21 (PA5)
/Current_2_measure: C67.1, D4.3 (common), R86.2, U5.22 (PA6)
/Current_measure_1/+15V: C89.1, D21.6 (+Vo), J16.1
/Current_measure_1/-15V: C91.2, D21.8 (-Vo), J16.2
/Current_measure_1/M: J16.3, R18.1, R56.2
/Current_measure_2/+15V: C90.1, D23.6 (+Vo), J17.1
/Current_measure_2/-15V: C92.2, D23.8 (-Vo), J17.2
/Current_measure_2/M: J17.3, R86.1, R87.2
/Relay_Control_1: R60.1, U5.43 (PA10)
/Relay_Control_2: R66.1, U5.41 (PA8)
/Relay_Control_3: R72.1, U5.39 (PC8)
/Relay_Control_4: R78.1, U5.37 (PC6)
/Relay_FeedBack_1: C74.1, D26.3 (common), R65.1, U5.42 (PA9), U8.3
/Relay_FeedBack_2: C75.1, D30.3 (common), R71.1, U5.40 (PC9), U10.3
/Relay_FeedBack_3: C76.1, D34.3 (common), R77.1, U5.38 (PC7), U12.3
/Relay_FeedBack_4: C77.1, D38.3 (common), R83.1, U5.36 (PB15), U14.3
/SWCLK: U5.49 (PA14), U16.1 (I/O1)
/SWDIO: U5.46 (PA13), U16.3 (I/O2)
/VDC_1_measure: C10.1, D1.3 (common), R10.2, U5.26 (PB0)
/VDC_2_measure: C43.1, D9.3 (common), R45.2, U5.25 (PC5)
/VDC_3_measure: C58.1, D80.3 (common), R138.2, U5.24 (PC4)
BOOT0: R11.2, U5.60 (BOOT0)
GND: C1.1, C2.2, C3.2, C4.2, C7.2, C10.2, C11.2, C13.2, C14.1, C15.2, C16.2, C17.2, C18.2, C19.2, C20.2, C21.2, C24.1, C25.2, C26.1, C27.2, C30.2, C34.1, C40.1, C41.2, C43.2, C44.1, C47.2, C48.2, C53.1, C54.2, C55.1, C56.2, C58.2, C59.1, C63.1, C64.2, C65.1, C66.2, C67.2, C70.2, C74.2, C75.2, C76.2, C77.2, C80.2, C89.2, C90.2, C91.1, C92.1, D1.1 (A), D2.5 (GND2), D3.1 (A), D4.1 (A), D9.1 (A), D12.3 (GND), D15.5 (GND2), D19.7 (0V), D21.7 (0V), D23.7 (0V), D26.1 (A), D30.1 (A), D34.1 (A), D38.1 (A), D80.1 (A), D82.5 (GND2), J1.1, Q9.2 (E), Q10.2 (E), R4.1, R11.1, R12.2, R33.1, R39.2, R57.2, R59.1, R65.2, R71.2, R77.2, R83.2, R90.1, R91.1, R92.2, U2.2 (V-), U3.2 (V-), U4.1 (GND), U5.12 (VSSA), U5.18 (VSS), U5.63 (VSS), U6.2 (V-), U7.2, U9.2, U11.2, U13.2, U16.2 (GND), U32.2 (V-), U33.2 (V-), Y1.2, Y1.4
GNDD: C38.2, C39.2, C68.2, C69.2, C71.2, C72.2, C79.2, C81.2, C82.2, C85.2, C86.2, D18.1 (GND), D19.1 (GND), H1.1 (1_1), H2.1 (1_1), L5.3, L7.3, Q2.3 (S), Q2.4 (S), Q3.3 (S), Q3.4 (S), Q4.3 (S), Q4.4 (S), Q5.3 (S), Q5.4 (S), Q6.2 (D), R62.1, R64.2, R68.1, R70.2, R74.1, R76.2, R80.1, R82.2, R85.2, U8.2, U10.2, U12.2, U14.2, U15.1 (GND)
GNDPWR: C5.2, C9.2, C22.1, C23.2, C35.1, C36.1, C37.1, C42.2, C46.1, C52.2, C57.2, C61.1, C62.2, C73.1, D2.3 (SHTDN), D2.4 (GND1), D7.1 (K), D15.3 (SHTDN), D15.4 (GND1), D16.1 (K), D18.7 (0V), D82.3 (SHTDN), D82.4 (GND1), D83.1 (K), J5.1, J5.2, J7.1, J7.2, J33.1, J33.2, R9.1, R24.2, R44.1, R52.2, R137.1, U17.2 (V-), U31.1 (GND)
GND_CAN: C49.2, D12.5 (CANG), D14.3 (A), J34.3, J34.4, J35.3, J35.4
NRST: C65.2, R14.2, U5.7 (NRST)
unnamed: C12.2, R10.1, R21.2, U6.1
unnamed: C45.2, R45.1, R47.2, U32.1
unnamed: C49.1, R37.1, R40.2
unnamed: C60.2, R138.1, R140.2, U33.1
unnamed: C82.1, L4.2, L5.1
unnamed: C86.1, L6.2, L7.1
unnamed: D2.6 (OUTN), R13.1
unnamed: D2.7 (OUTP), R8.1
unnamed: C9.1, D2.2 (VIN), R7.1
unnamed: D5.2 (A), J1.4
unnamed: D6.2 (A), R25.2
unnamed: D6.1 (K), D7.2 (A)
unnamed: D8.2 (A), U5.3 (PC14)
unnamed: D8.1 (K), R12.1
unnamed: D10.2 (A), R34.2
unnamed: D10.1 (K), D16.2 (A)
unnamed: D11.1 (K), R39.1
unnamed: D12.7 (CANH), L1.1, R37.2
unnamed: D12.6 (CANL), L1.2, R40.1
unnamed: D15.6 (OUTN), R46.1
unnamed: D15.7 (OUTP), R43.1
unnamed: C42.1, D15.2 (VIN), R42.1
unnamed: D17.1 (K), R52.1
unnamed: C35.2, D18.6 (+Vo), U31.3 (VI)
unnamed: C37.2, D18.8 (CS)
unnamed: C39.1, D18.2 (Vin), L2.2
unnamed: C69.1, D19.2 (Vin), L3.2
unnamed: C83.2, C84.2, D21.1 (GND), L5.4
unnamed: C83.1, C84.1, D21.2 (Vin), L5.2
unnamed: D22.1 (K), R57.1
unnamed: C87.2, C88.2, D23.1 (GND), L7.4
unnamed: C87.1, C88.1, D23.2 (Vin), L7.2
unnamed: D24.2 (A), J8.1, Q2.2 (D), R61.2
unnamed: D25.1 (K), R61.1
unnamed: D27.2 (A), J9.1, R63.2
unnamed: D27.1 (K), R64.1
unnamed: D28.2 (A), J10.1, Q3.2 (D), R67.2
unnamed: D29.1 (K), R67.1
unnamed: D31.2 (A), J11.1, R69.2
unnamed: D31.1 (K), R70.1
unnamed: D32.2 (A), J12.1, Q4.2 (D), R73.2
unnamed: D33.1 (K), R73.1
unnamed: D35.2 (A), J13.1, R75.2
unnamed: D35.1 (K), R76.1
unnamed: D36.2 (A), J14.1, Q5.2 (D), R79.2
unnamed: D37.1 (K), R79.1
unnamed: D39.2 (A), J15.1, R81.2
unnamed: D39.1 (K), R82.1
unnamed: C78.2, D40.2 (A), Q1.3 (S), Q6.3 (S), R84.2
unnamed: C78.1, D40.1 (K), Q1.1 (G), Q6.1 (G), R55.1, R84.1
unnamed: D41.1 (K), R85.1
unnamed: D42.2 (A), U5.2 (PC13)
unnamed: D42.1 (K), R92.1
unnamed: D81.2 (A), R132.2
unnamed: D81.1 (K), D83.2 (A)
unnamed: D82.6 (OUTN), R139.1
unnamed: D82.7 (OUTP), R136.1
unnamed: C57.1, D82.2 (VIN), R135.1
unnamed: J1.2, R95.2
unnamed: J1.3, R54.2
unnamed: J3.1, J3.2, R1.2, R27.1
unnamed: J4.1, J4.2, R28.1, R29.2
unnamed: J32.1, J32.2, R48.1, R49.2
unnamed: Q2.1 (G), R62.2, U7.3
unnamed: Q3.1 (G), R68.2, U9.3
unnamed: Q4.1 (G), R74.2, U11.3
unnamed: Q5.1 (G), R80.2, U13.3
unnamed: Q7.1 (B), Q9.1 (B), U2.1
unnamed: C70.1, Q7.2 (E), Q9.3 (C), R56.1, U2.4 (-)
unnamed: Q8.1 (B), Q10.1 (B), U3.1
unnamed: C80.1, Q8.2 (E), Q10.3 (C), R87.1, U3.4 (-)
unnamed: R1.1, R2.2
unnamed: R2.1, R3.2
unnamed: R3.1, R6.2
unnamed: R5.1, R6.1, R7.2, R9.2
unnamed: R25.1, R26.2
unnamed: R26.1, R27.2
unnamed: R28.2, R31.1
unnamed: R29.1, R30.2
unnamed: R30.1, R32.2
unnamed: R31.2, R34.1
unnamed: R32.1, R41.2
unnamed: R38.1, R41.1, R42.2, R44.2
unnamed: R48.2, R51.1
unnamed: R49.1, R50.2
unnamed: R50.1, R53.2
unnamed: R54.1, U16.4 (I/O2)
unnamed: R60.2, U7.1
unnamed: R63.1, U8.1
unnamed: R66.2, U9.1
unnamed: R69.1, U10.1
unnamed: R72.2, U11.1
unnamed: R75.1, U12.1
unnamed: R78.2, U13.1
unnamed: R81.1, U14.1
unnamed: R95.1, U16.6 (I/O1)
unnamed: R51.2, R132.1
unnamed: R133.1, R134.1, R135.2, R137.2
unnamed: R53.1, R134.2
unnamed: C14.2, R88.2, R90.2, U2.3 (+)
unnamed: C59.2, R89.2, R91.2, U3.3 (+)
unnamed: C26.2, U5.5 (PH0), Y1.3
unnamed: C30.1, U5.6 (PH1), Y1.1
unnamed: C21.1, U5.31 (VCAP_1)
unnamed: C27.1, U5.47 (VCAP_2)
unnamed: C1.2, R4.2, R8.2, U6.3 (+)
unnamed: C12.1, R13.2, R21.1, U6.4 (-)
unnamed: C73.2, R23.2, R24.1, U17.3 (+)
unnamed: C40.2, R33.2, R43.2, U32.3 (+)
unnamed: C45.1, R46.2, R47.1, U32.4 (-)
unnamed: C55.2, R59.2, R136.2, U33.3 (+)
unnamed: C60.1, R139.2, R140.1, U33.4 (-)
