Alexandr-Filatov/PDU_Container_MCU_PCB/(commit log)

2026-06-05 zero commit
    [0039281063.stp, 0039288040.stp, 0300700235.stp, 0353180420.stp, 039288020.stp, 1-776087-1.step, 1-776087-1_v2.stp, 2071583-4.stp]
2026-06-08 VER1.0: добавил функционалку и расставил все на плате
    [Current_measure.kicad_sch, Functional_Sch.kicad_pcb, Functional_Sch.kicad_sch, PDU_Container_MCU_PCB.kicad_pcb, PDU_Container_MCU_PCB.kicad_sch, PDU_Container_MCU_PCB_BOM_08.06.2026_EN.xlsx, PDU_Container_MCU_PCB_BOM_08.06.2026_RU.xlsx]
2026-06-09 VER1.0: оптимизировал схему измерения напряжения
    [PDU_Container_MCU_PCB.kicad_pcb, PDU_Container_MCU_PCB.kicad_sch, Voltage_measure.kicad_sch]
2026-06-10 VER1.0: плата разведена
    [Current_measure.kicad_sch, PDU_Container_MCU_PCB.kicad_pcb, PDU_Container_MCU_PCB.kicad_sch]
2026-06-11 VER1.0: плата разведена, файлы по плате готовы
    [Current_measure.kicad_sch, Functional_Sch.kicad_sch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]
2026-06-11 VER1.0: поправил BOM
    [Current_measure.kicad_sch, PDU_Container_MCU_PCB.kicad_pcb, PDU_Container_MCU_PCB.kicad_sch, PDU_Container_MCU_PCB_BOM_11.06.2026_EN.xlsx, PDU_Container_MCU_PCB_BOM_11.06.2026_RU.xlsx, Плата управления БРВН BOM_v1.0.xlsx]
2026-07-08 VER1.0: обновил гербера и BOM
    [Current_measure.kicad_sch, PDU_Container_MCU_PCB.kicad_pcb, PDU_Container_MCU_PCB.kicad_sch, PDU_Container_MCU_PCB_BOM_08.07.2026_EN.xlsx, PDU_Container_MCU_PCB_BOM_08.07.2026_RU.xlsx, PDU_Container_MCU_PCB_BOM_11.06.2026_EN.xlsx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]
2026-08-03 VER1.0: добавил папку с чертежами
    [НВЦТ.EVP150-2-1.2000.120_v1.dwg]
2026-08-04 VER1.0: добавил интерактивный BOM
